L-z812/stm32-smart-fan/docs/assets/demo-sensor.jpg

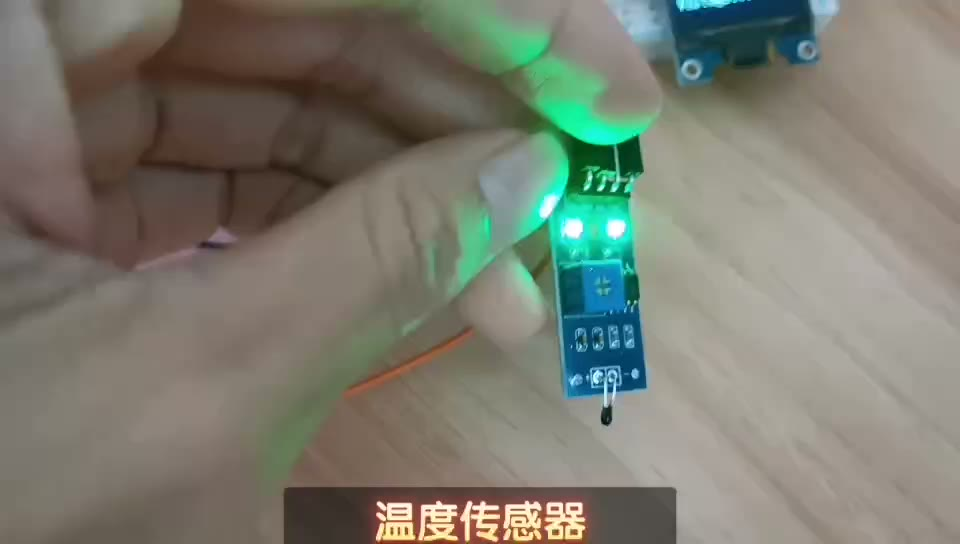
docs/assets/demo-sensor.jpg
