L-z812/stm32-smart-fan/Hardware/Motor.c

#include "stm32f10x.h"                  // Device header
#include "PWM.h"

/**
  * 函    数：直流电机初始化
  * 参    数：无
  * 返 回 值：无
  * 说    明：只负责方向引脚 PA4/PA5 和底层 PWM（PA2），
  *           红绿灯交给 LED 模块，蜂鸣器交给 Timer 模块，各管各的引脚。
  */
void Motor_Init(void)
{
	/*开启时钟*/
	RCC_APB2PeriphClockCmd(RCC_APB2Periph_GPIOA, ENABLE);		//开启GPIOA的时钟
	
	/*GPIO初始化*/
	GPIO_InitTypeDef GPIO_InitStructure;
	GPIO_InitStructure.GPIO_Mode = GPIO_Mode_Out_PP;
	GPIO_InitStructure.GPIO_Pin = GPIO_Pin_4 | GPIO_Pin_5;
	GPIO_InitStructure.GPIO_Speed = GPIO_Speed_50MHz;
	GPIO_Init(GPIOA, &GPIO_InitStructure);						//将PA4和PA5引脚初始化为推挽输出
	
	/*上电默认让电机停转*/
	GPIO_ResetBits(GPIOA, GPIO_Pin_4 | GPIO_Pin_5);
	
	PWM_Init();													//初始化直流电机的底层PWM
}

/**
  * 函    数：直流电机设置速度
  * 参    数：Speed 要设置的速度，范围：-99~99（负数代表反转）
  * 返 回 值：无
  */
void Motor_SetSpeed(int16_t Speed)
{
	if (Speed >= 0)							//如果设置正转的速度值
	{
		GPIO_SetBits(GPIOA, GPIO_Pin_4);	//PA4置高电平
		GPIO_ResetBits(GPIOA, GPIO_Pin_5);	//PA5置低电平，设置方向为正转
		PWM_SetCompare3(Speed);				//PWM设置为速度值
	}
	else									//否则，即设置反转的速度值
	{
		GPIO_ResetBits(GPIOA, GPIO_Pin_4);	//PA4置低电平
		GPIO_SetBits(GPIOA, GPIO_Pin_5);	//PA5置高电平，设置方向为反转
		PWM_SetCompare3(-Speed);			//PWM只能给正数，所以取相反数
	}
}
