L-z812/stm32-smart-fan/Hardware/AD.c

#include "stm32f10x.h"                  // Device header

/**
  * 函    数：AD初始化
  * 参    数：无
  * 返 回 值：无
  */
void AD_Init(void)
{
	/*开启时钟*/
	RCC_APB2PeriphClockCmd(RCC_APB2Periph_ADC1, ENABLE);	//开启ADC1的时钟
	RCC_APB2PeriphClockCmd(RCC_APB2Periph_GPIOA, ENABLE);	//开启GPIOA的时钟
	
	/*设置ADC时钟*/
	RCC_ADCCLKConfig(RCC_PCLK2_Div6);						//选择时钟6分频，ADCCLK = 72MHz / 6 = 12MHz
	
	/*GPIO初始化*/
	GPIO_InitTypeDef GPIO_InitStructure;
	GPIO_InitStructure.GPIO_Mode = GPIO_Mode_AIN;
	GPIO_InitStructure.GPIO_Pin = GPIO_Pin_0;
	GPIO_InitStructure.GPIO_Speed = GPIO_Speed_50MHz;
	GPIO_Init(GPIOA, &GPIO_InitStructure);					//将PA0引脚初始化为模拟输入
	
	/*规则组通道配置*/
	ADC_RegularChannelConfig(ADC1, ADC_Channel_0, 1, ADC_SampleTime_55Cycles5);		//规则组序列1的位置，配置为通道0
	
	/*ADC初始化*/
	ADC_InitTypeDef ADC_InitStructure;						//定义结构体变量
	ADC_InitStructure.ADC_Mode = ADC_Mode_Independent;		//模式，选择独立模式，即单独使用ADC1
	ADC_InitStructure.ADC_DataAlign = ADC_DataAlign_Right;	//数据对齐，选择右对齐
	ADC_InitStructure.ADC_ExternalTrigConv = ADC_ExternalTrigConv_None;	//外部触发，使用软件触发，不需要外部触发
	ADC_InitStructure.ADC_ContinuousConvMode = DISABLE;		//连续转换，失能，每转换一次规则组序列后停止
	ADC_InitStructure.ADC_ScanConvMode = DISABLE;			//扫描模式，失能，只转换规则组的序列1这一个位置
	ADC_InitStructure.ADC_NbrOfChannel = 1;					//通道数，为1，仅在扫描模式下，才需要指定大于1的数，在非扫描模式下，只能是1
	ADC_Init(ADC1, &ADC_InitStructure);						//将结构体变量交给ADC_Init，配置ADC1
	
	/*ADC使能*/
	ADC_Cmd(ADC1, ENABLE);									//使能ADC1，ADC开始运行
	
	/*ADC校准*/
	ADC_ResetCalibration(ADC1);								//固定流程，内部有电路会自动执行校准
	while (ADC_GetResetCalibrationStatus(ADC1) == SET);
	ADC_StartCalibration(ADC1);
	while (ADC_GetCalibrationStatus(ADC1) == SET);
}

/**
  * 函    数：获取AD转换的值
  * 参    数：无
  * 返 回 值：AD转换的值，范围：0~4095
  */
uint16_t AD_GetValue(void)
{
	ADC_SoftwareStartConvCmd(ADC1, ENABLE);					//软件触发AD转换一次
	while (ADC_GetFlagStatus(ADC1, ADC_FLAG_EOC) == RESET);	//等待EOC标志位，即等待AD转换结束
	return ADC_GetConversionValue(ADC1);					//读数据寄存器，得到AD转换的结果
}

/**
  * 函    数：采集温度（含数字滤波和线性标定）
  * 参    数：无
  * 返 回 值：温度，范围 0~100（单位：℃）
  * 注意事项：1. 连采 8 次取平均，抑制 ADC 末位跳动，读数不会个位数乱闪
  *           2. NTC 分压后的电压与温度近似线性，标定式为 T = 100 - (AD - 1730) / 2.1
  *              即 AD 1730 对应 100℃，AD 1940 对应 0℃
  *           3. 必须先把 AD 值转成 int32_t 再减 1730，
  *              否则无符号数相减会得到 42 亿多，再转 int16_t 就溢出了
  *           4. 结果限幅在 0~100：传感器没接或接触不良时 AD 会跑到 0，
  *              不限幅的话温度会算出几百，OLED 上会显示成天文数字
  */
int16_t AD_GetTemperature(void)
{
	uint32_t Sum = 0;
	uint8_t i;
	int32_t Average;
	int16_t Temp;
	
	for (i = 0; i < 8; i++)
	{
		Sum += AD_GetValue();
	}
	Average = (int32_t)(Sum / 8);							//先转有符号，再参与后续运算
	Temp = (int16_t)(100 - (Average - 1730) / 2.1f);		//线性标定到 0~100℃
	
	if (Temp < 0)	Temp = 0;
	if (Temp > 100)	Temp = 100;
	
	return Temp;
}
