L-z812/stm32-smart-fan/(commit log)

2026-10-28 feat: STM32 智能降温风扇（温度自动调速 + 旋钮手动调速 + 超温报警）
2026-10-28 fix(v2): 修复 8 个硬伤 —— 蜂鸣器迁到 TIM3、删除 Key 与编码器抢 PB1、Speed 改 int16_t 并真正限幅
    1. Timer 模块改用 TIM3（ARR=999/PSC=71，1kHz），TIM2 只归 PWM，
    解决 PWM 被二次配置成 ARR=9 导致只有 10 级调速的问题
    2. 报警不再 TIM_SetAutoreload(TIM2,190)，改为 Buzzer_Set() 切标志位，
    音调固定 500Hz，报警结束后占空比不再被永久改变
    3. 删除 Key.c/Key.h 及 main.c 中的 Key_GetNum() 调用，
    PB1 只作为编码器 B 相，转旋钮不再阻塞主循环
    4. LED 重写为 PA8/PA9 并真正调用 LED_Init()，Motor_Init 不再越权配灯
    5. PB12 由 Timer 模块自己初始化，OLED.c 的 GPIO_Pin_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
